Ryujikoyasu/ohana-robot-develop/README.md

ここでは，OHANA-ROBOTの開発に関する問題を扱います．
今後も増やしていく予定です．  

1. [クローラ](Crawler)
2. [除草用マニピュレータ](Manipulator)
