Ryujikoyasu/ohana-robot-develop/Crawler/software/README.md

# ロボットの動かし方 【ソフトウェア】

クローラを動かすには，モータを制御する必要がある．
私は，Ubuntu22.04の環境で，ROS 2 Humbleを用いている．オリエンタルモータの方で[公式ライブラリ](https://www.orientalmotor.co.jp/ja/support/connection-partners)が用意されていて，これを少し改良すれば速度制御ができる．非常に高機能なモータの仕様になっており，エンコーダのオドメトリ取りたいとか，電流値取りたいとか，何かあればコマンドや設定に反映する必要がある．

で，ここで説明したいのは，ビジョンセンサとの連携．  

### ビジョンAIを用いたい理由
私は，GPSもLiDARもオドメトリ情報も使わない．非常にシンプルでインチキな，低レベルな制御をしたいのです．ライントレースに毛を生やしたような感じが良い．  
自動車の自動運転とは全く環境や条件が異なって，特徴量がなかったり激しく変化したり，そして利用者がその土地の人のみ，というようにマッピングのコストが割に合わない，故にビジョンSLAMは使えない．  
GPSでは使える環境が限られたり柔軟性に欠けたりするため，対話可能性が下がる．  
もちろん，大規模農家や工業的な農業をしている場合や，果樹園などでは，今から議論する方法は不向きで非効率的であるだろう．
しかし，私がこれから試みる方法というのは，人間の助けを借りながら弱い自律性もある，そんな方法である．
即ち，カメラで見た状況から進むべきゴールを定め，そこに向かって走行したり追従したりする．
例えば，道とか，特定の目標物とか，人とか，作物列とか.
本当はそこにもう一つメタ的なトポロジカルマップを構築したかったのだが，複雑すぎる環境で実験していたため半年では上手くいかず．環境整備して環境を単純化すればいけるとは思うが．足回りの制約も大きい．段差があるとか，茂みにコンクリのブロックがあるとか，水道管があるとか，，，この辺は手に負えなかった．
自律性を上げるためには環境整備とマッピング・マップのメンテのコストが増大する．
どこでも通用する手法は今のところないから，その類の批判はナンセンスである．

### ビジョンAIの技術

さて，この方法で重要な技術は，
1. 物体検出
2. セグメンテーション
3. 深度推定
4. トラッキング
5. LLM

の５つである．
それぞれで，次々と新しい手法が提案されている．
ここでは，サーバによる処理を前提としてVision Transformerモデルを積極的に用いて取り組んでいく．

### ViTに期待すること

### 具体的なモデル

### 制御方法

OpenAI
