Ryujikoyasu/ohana-robot-develop/Manipulator/img/armlink.png

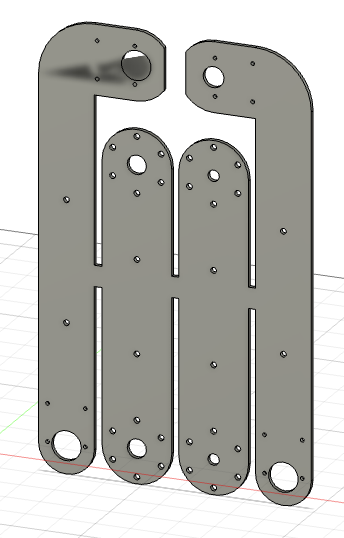
Manipulator/img/armlink.png
