Ryujikoyasu/ohana-robot-develop/Manipulator/step/base.step

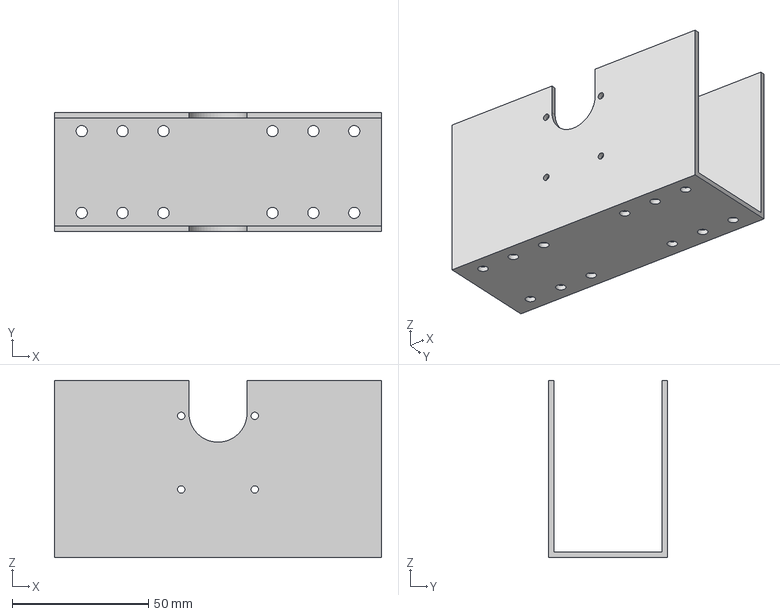
[picture p29: CAD file, 2024-01-30]
Manipulator/step/base.step
120.0 x 43.5 x 65.0 mm
