Ryujikoyasu/ohana-robot-develop/Manipulator/stl/link1_collision.stl

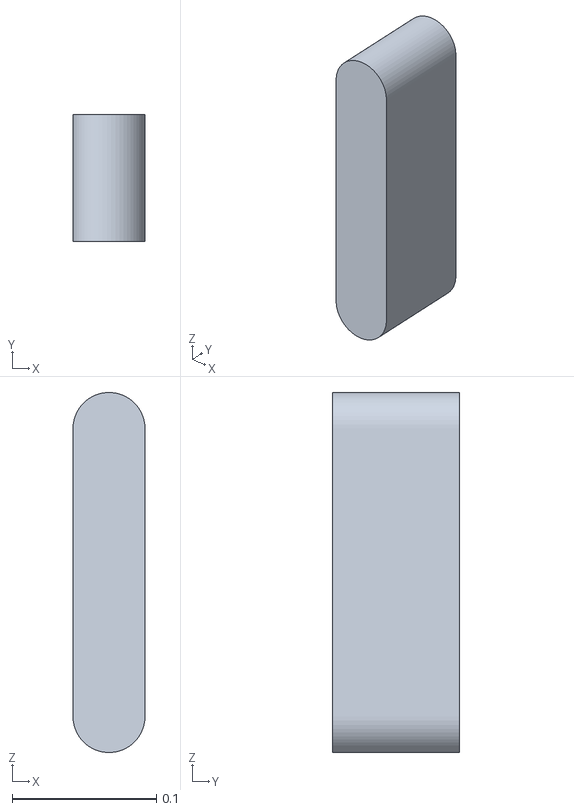
[picture p30: CAD file, 2024-01-31]
Manipulator/stl/link1_collision.stl
0.05 x 0.0885 x 0.25
