Ryujikoyasu/ohana-robot-develop/Crawler/step/frame1.step

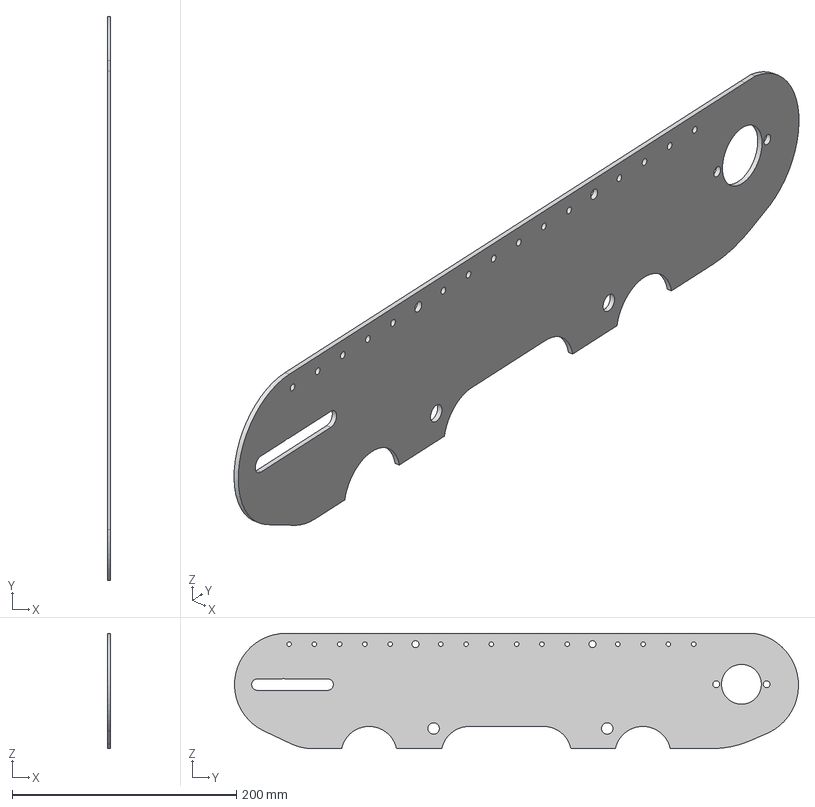
[picture p31: CAD file, 2024-02-01]
Crawler/step/frame1.step
3.00 x 503.2 x 102.8 mm
