Ryujikoyasu/ohana-robot-develop/Manipulator/step/horn_ee2.step

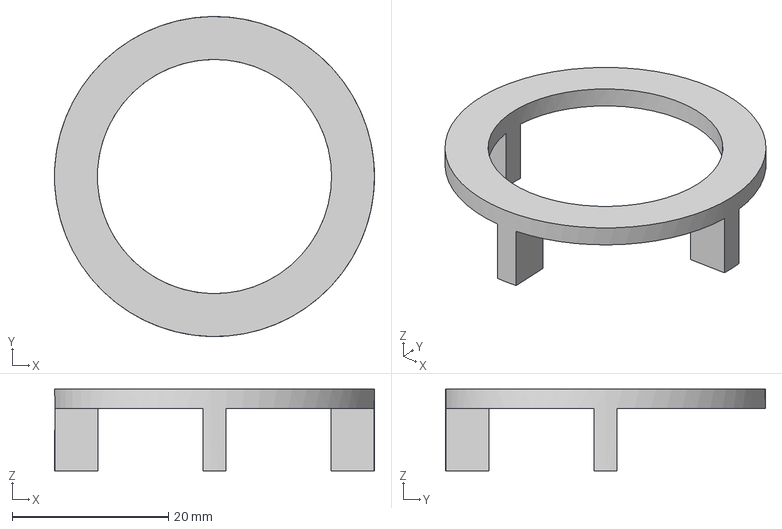
[picture p32: CAD file, 2024-01-30]
Manipulator/step/horn_ee2.step
41.0 x 41.0 x 10.5 mm
