Ryujikoyasu/ohana-robot-develop/Manipulator/stl/balican_collision.stl

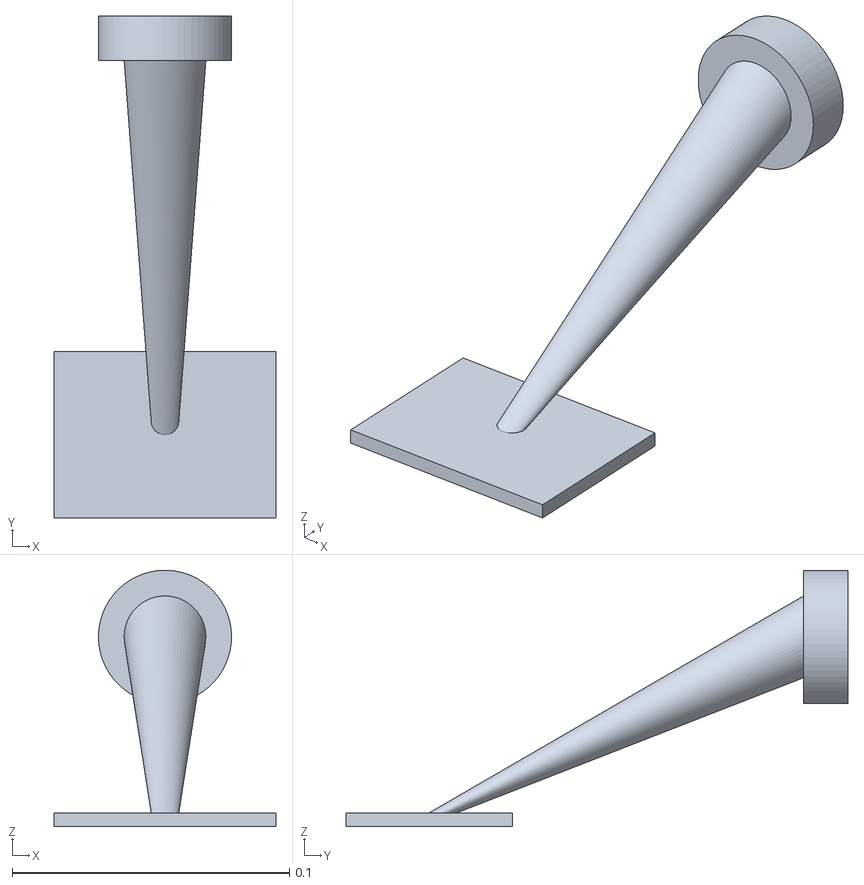
[picture p33: CAD file, 2024-01-31]
Manipulator/stl/balican_collision.stl
0.08 x 0.181 x 0.0924
