Ryujikoyasu/ohana-robot-develop/Crawler/step/equalizers.step

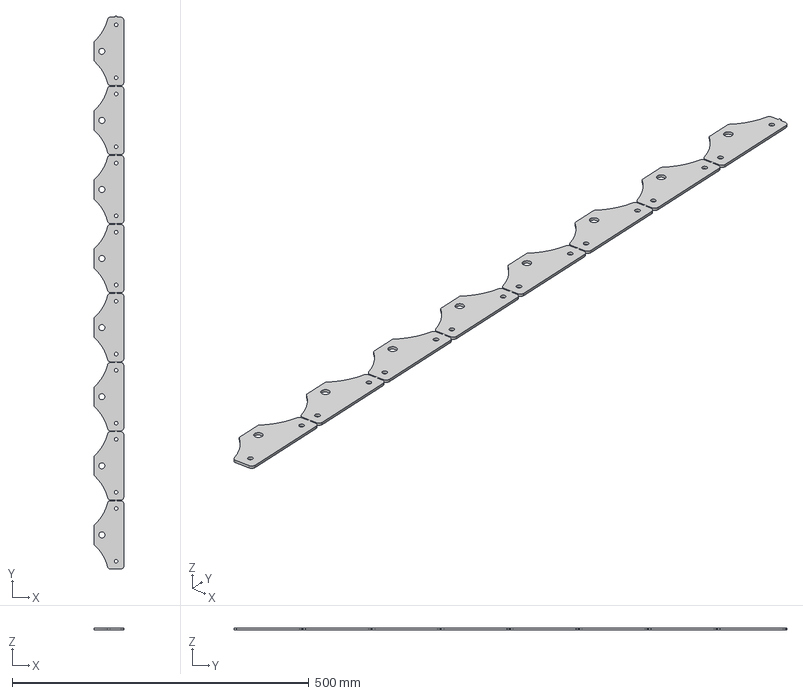
[picture p34: CAD file, 2024-02-01]
Crawler/step/equalizers.step
50.0 x 932.0 x 3.00 mm
Equalizer x 8
