Ryujikoyasu/ohana-robot-develop/Manipulator/step/horn3.step

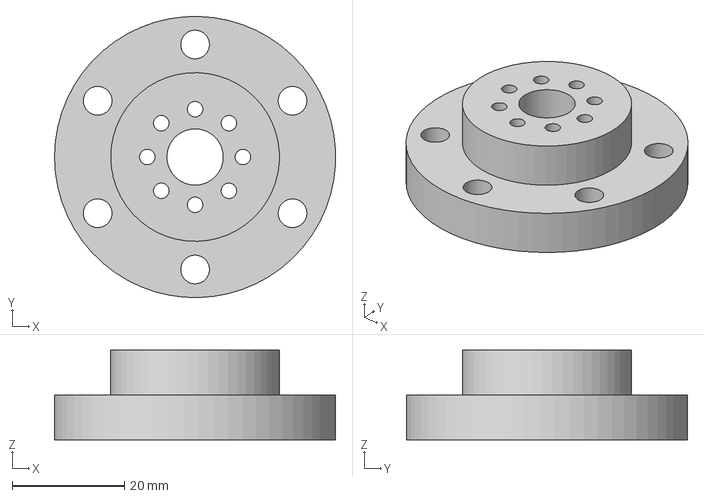
[picture p35: CAD file, 2024-01-30]
Manipulator/step/horn3.step
50.0 x 50.0 x 16.0 mm
