Ryujikoyasu/ohana-robot-develop/Manipulator/step/horn_ee1.step

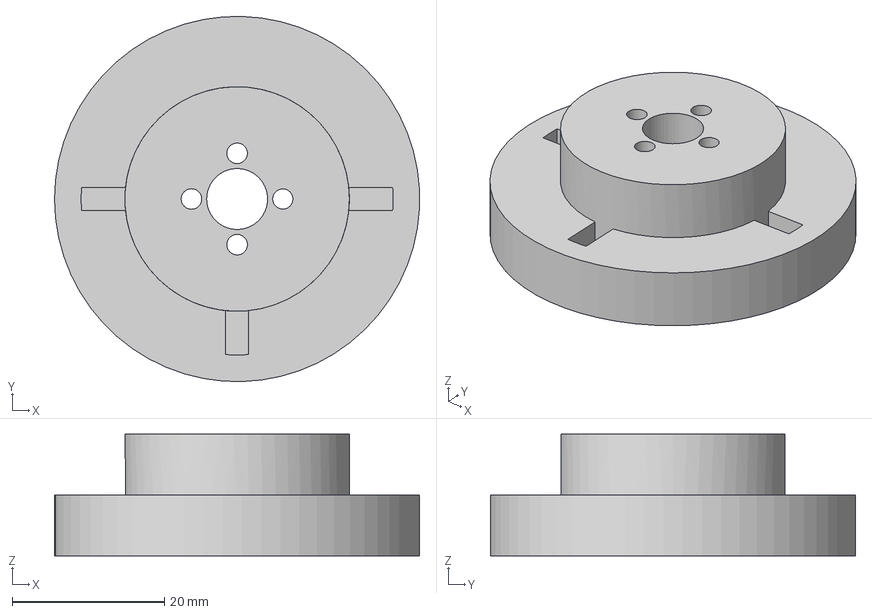
[picture p36: CAD file, 2024-01-30]
Manipulator/step/horn_ee1.step
48.0 x 48.0 x 16.0 mm
