Ryujikoyasu/ohana-robot-develop/Manipulator/stl/base_collision.stl

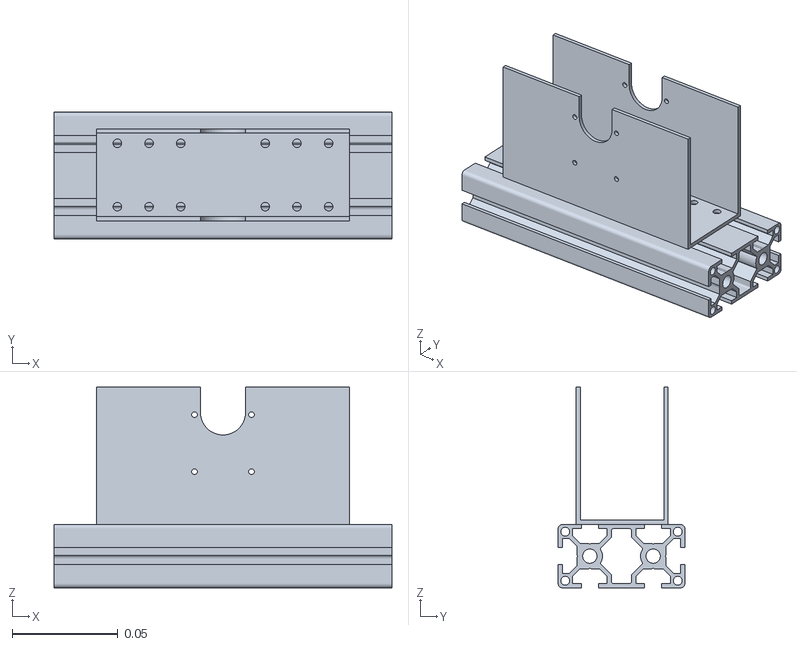
[picture p37: CAD file, 2024-01-31]
Manipulator/stl/base_collision.stl
0.16 x 0.06 x 0.095
