Ryujikoyasu/ohana-robot-develop/Manipulator/step/horn2.step

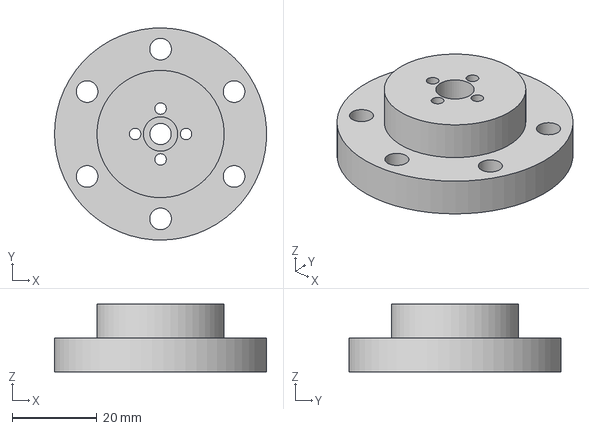
[picture p38: CAD file, 2024-01-30]
Manipulator/step/horn2.step
50.0 x 50.0 x 16.0 mm
