Ryujikoyasu/ohana-robot-develop/Manipulator/step/armlink.step

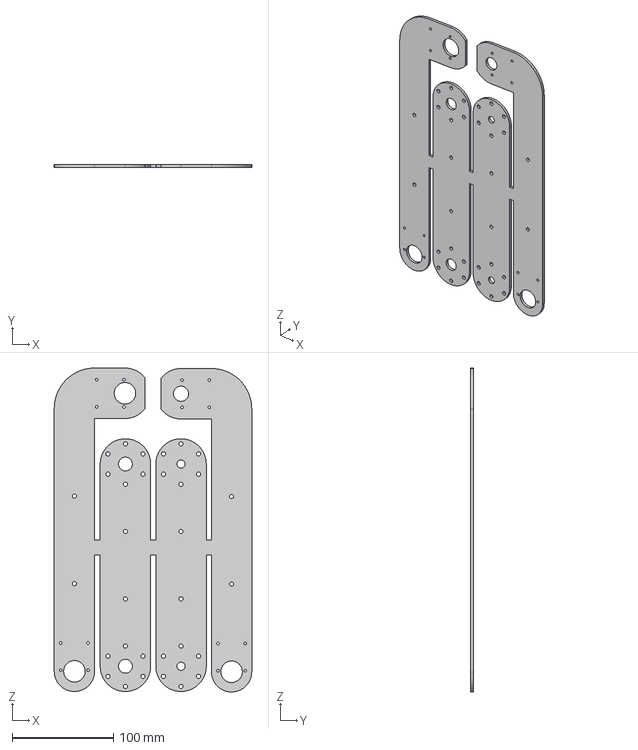
[picture p39: CAD file, 2024-01-30]
Manipulator/step/armlink.step
195.5 x 3.00 x 320.5 mm
