Ryujikoyasu/ohana-robot-develop/Manipulator/stl/link2.stl

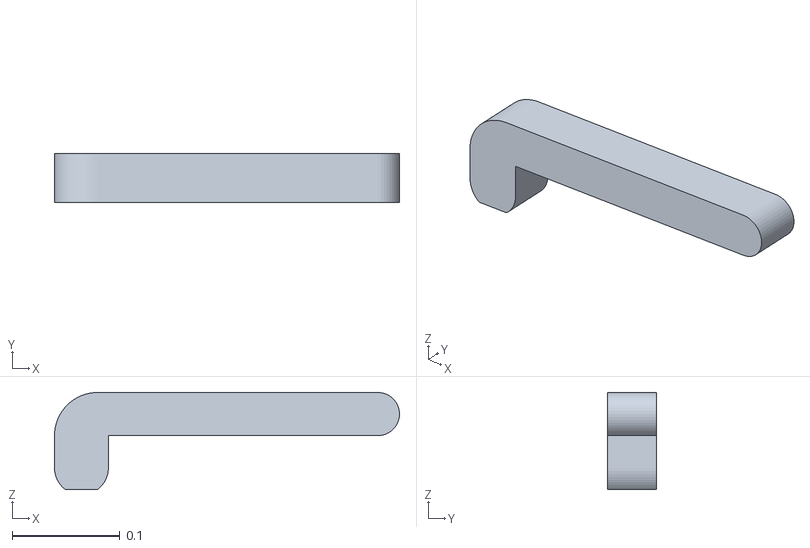
[picture p40: CAD file, 2024-01-31]
Manipulator/stl/link2.stl
0.32 x 0.0455 x 0.09
