Ryujikoyasu/ohana-robot-develop/Crawler/img/tire2.jpg

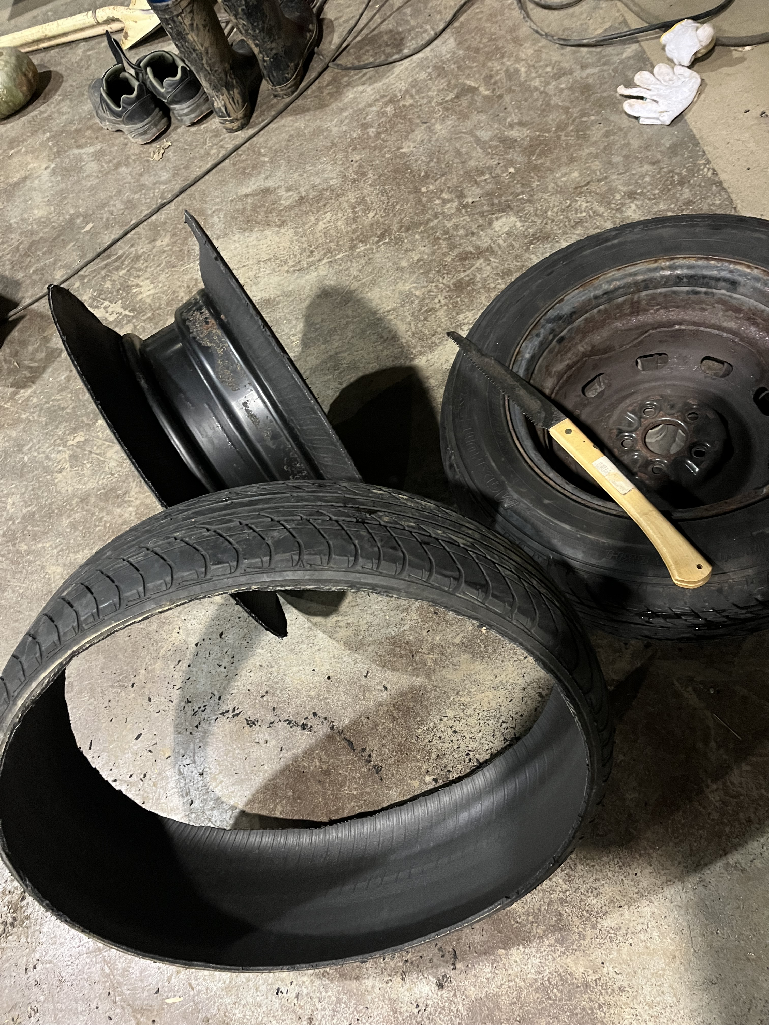
[picture p7: Crawler/img/tire2.jpg]
Crawler/img/tire2.jpg
