Ryujikoyasu/ohana-robot-develop/Crawler/img/tire3.jpg

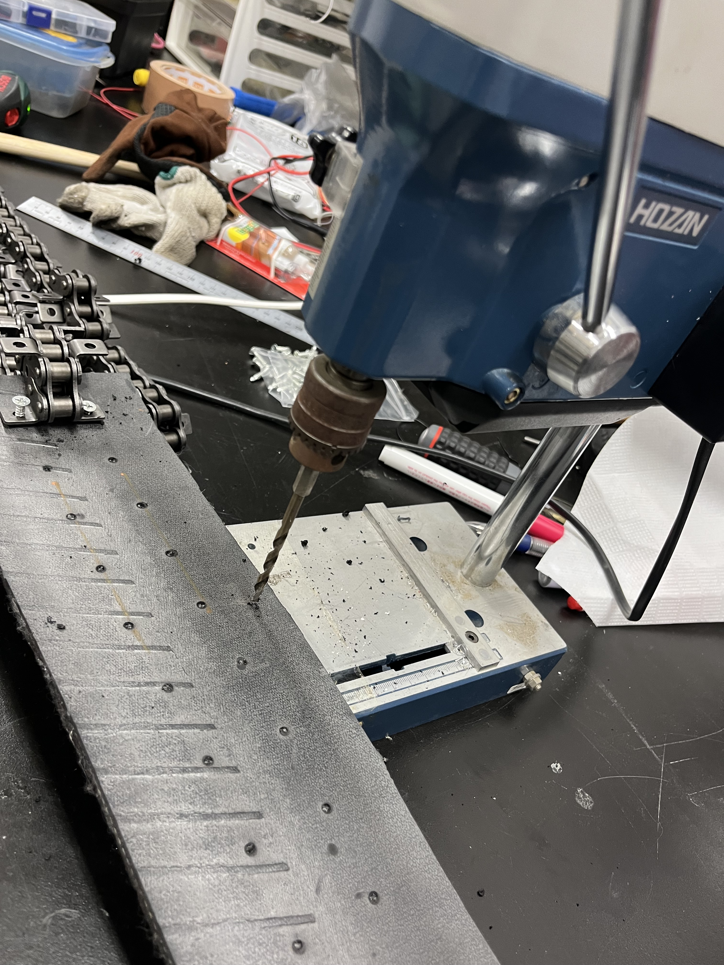
[picture p8: Crawler/img/tire3.jpg]
Crawler/img/tire3.jpg
