Ryujikoyasu/ohana-robot-develop/Crawler/img/tire4.jpg

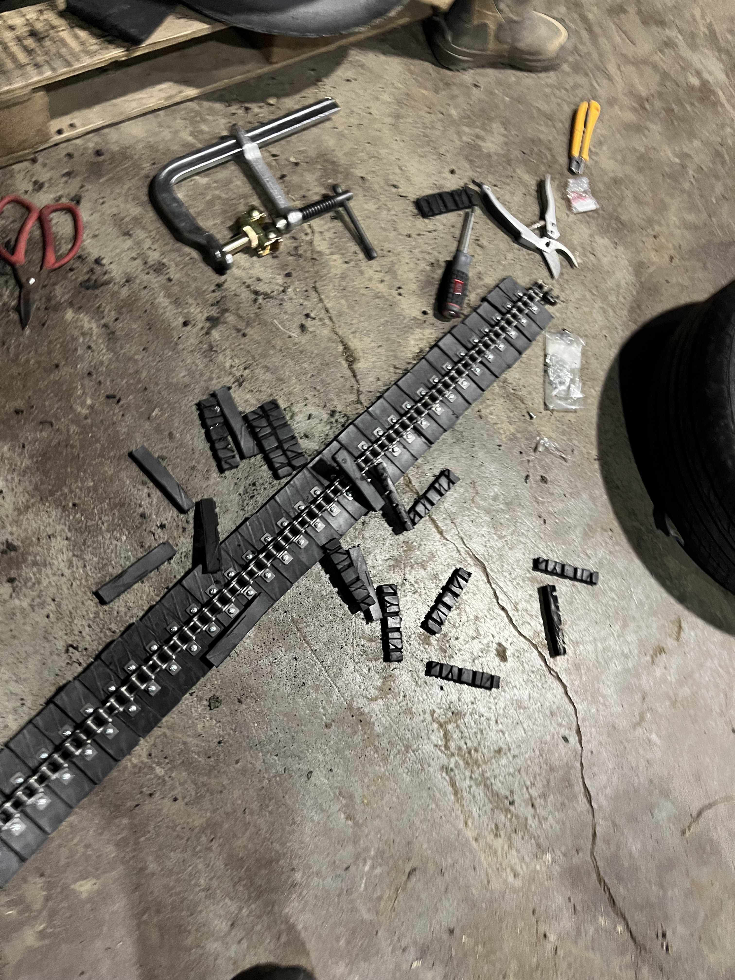
[picture p9: Crawler/img/tire4.jpg]
Crawler/img/tire4.jpg
