Ryujikoyasu/ohana-robot-develop/Manipulator/img/set_balican6.jpg

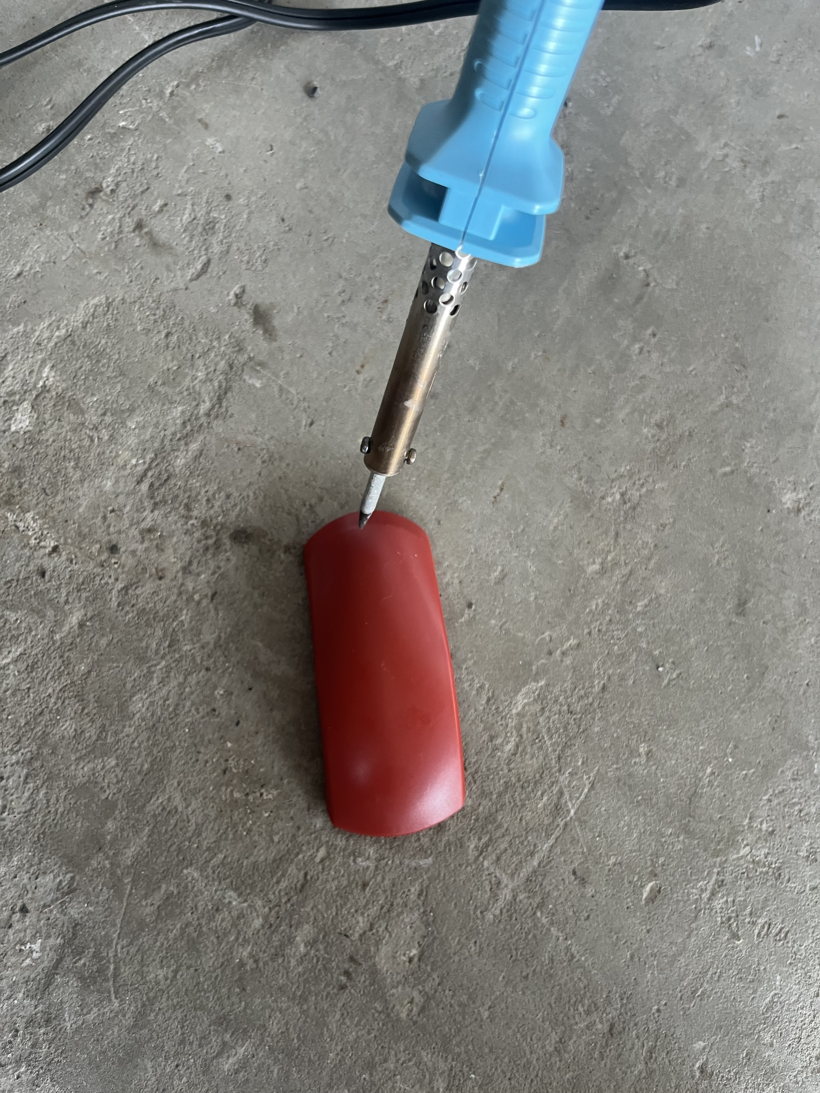
[picture p19: Manipulator/img/set_balican6.jpg]
Manipulator/img/set_balican6.jpg
