Ryujikoyasu/ohana-robot-develop/Manipulator/img/incorrect_balican.jpg

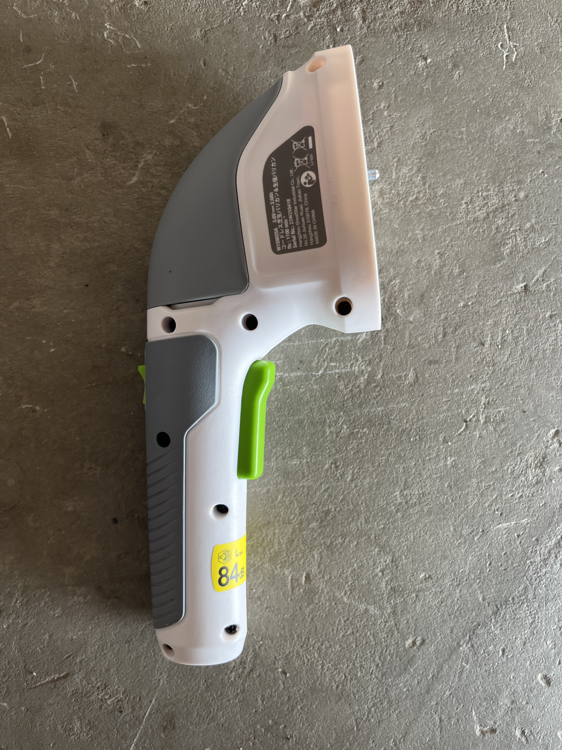
[picture p21: Manipulator/img/incorrect_balican.jpg]
Manipulator/img/incorrect_balican.jpg
