Ryujikoyasu/ohana-robot-develop/Manipulator/img/incorrect_balican3.jpg

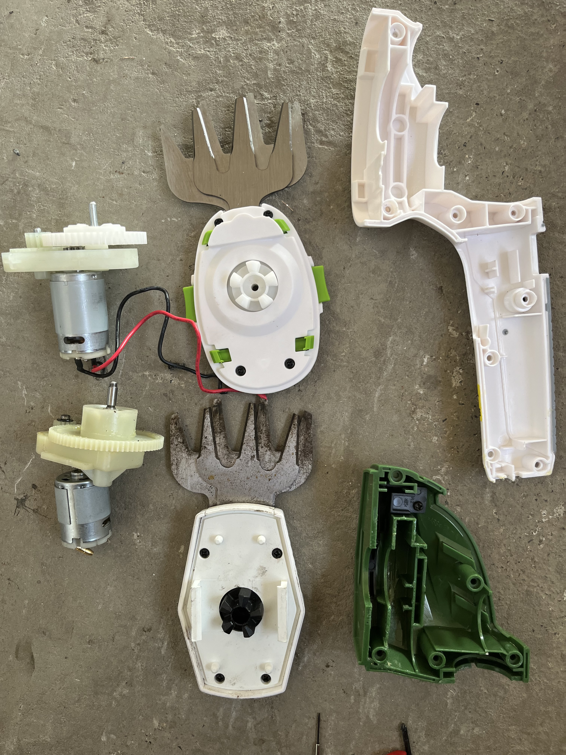
[picture p22: Manipulator/img/incorrect_balican3.jpg]
Manipulator/img/incorrect_balican3.jpg
