Ryujikoyasu/ohana-robot-develop/Manipulator/img/correct_balican.jpg

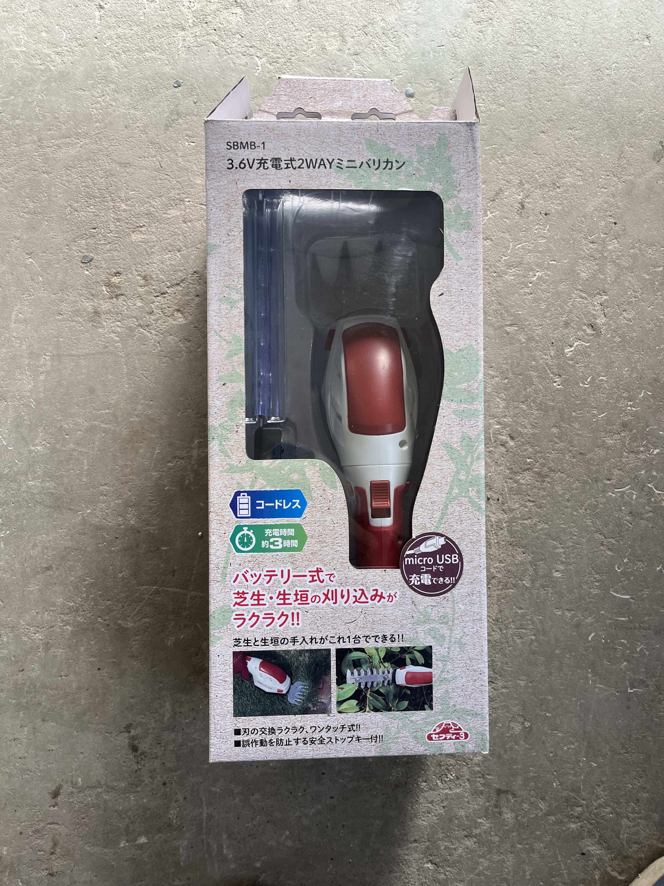
Manipulator/img/correct_balican.jpg
