Ryujikoyasu/ohana-robot-develop/Manipulator/img/set_balican5.jpg

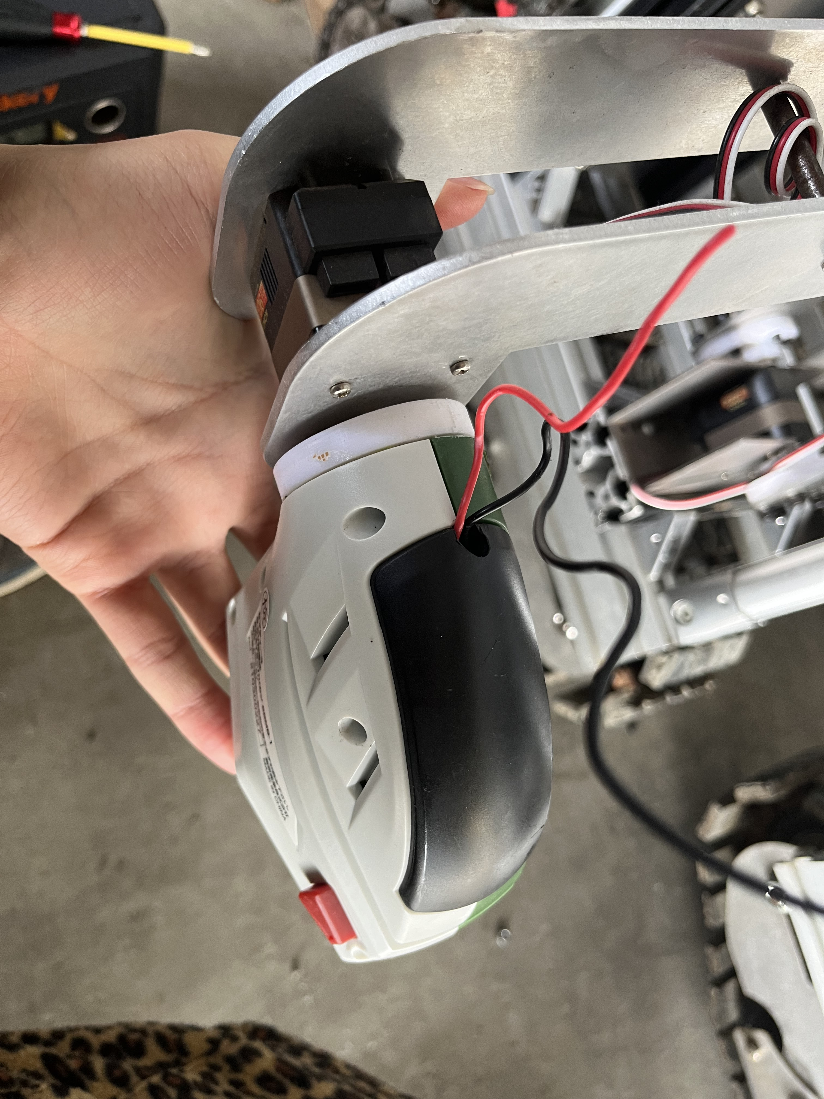
Manipulator/img/set_balican5.jpg
